zemonkey/Isolated_UART/Isolated_UART.kicad_pcb

## KiCad design Isolated_UART.kicad_pcb (2022-06-12)

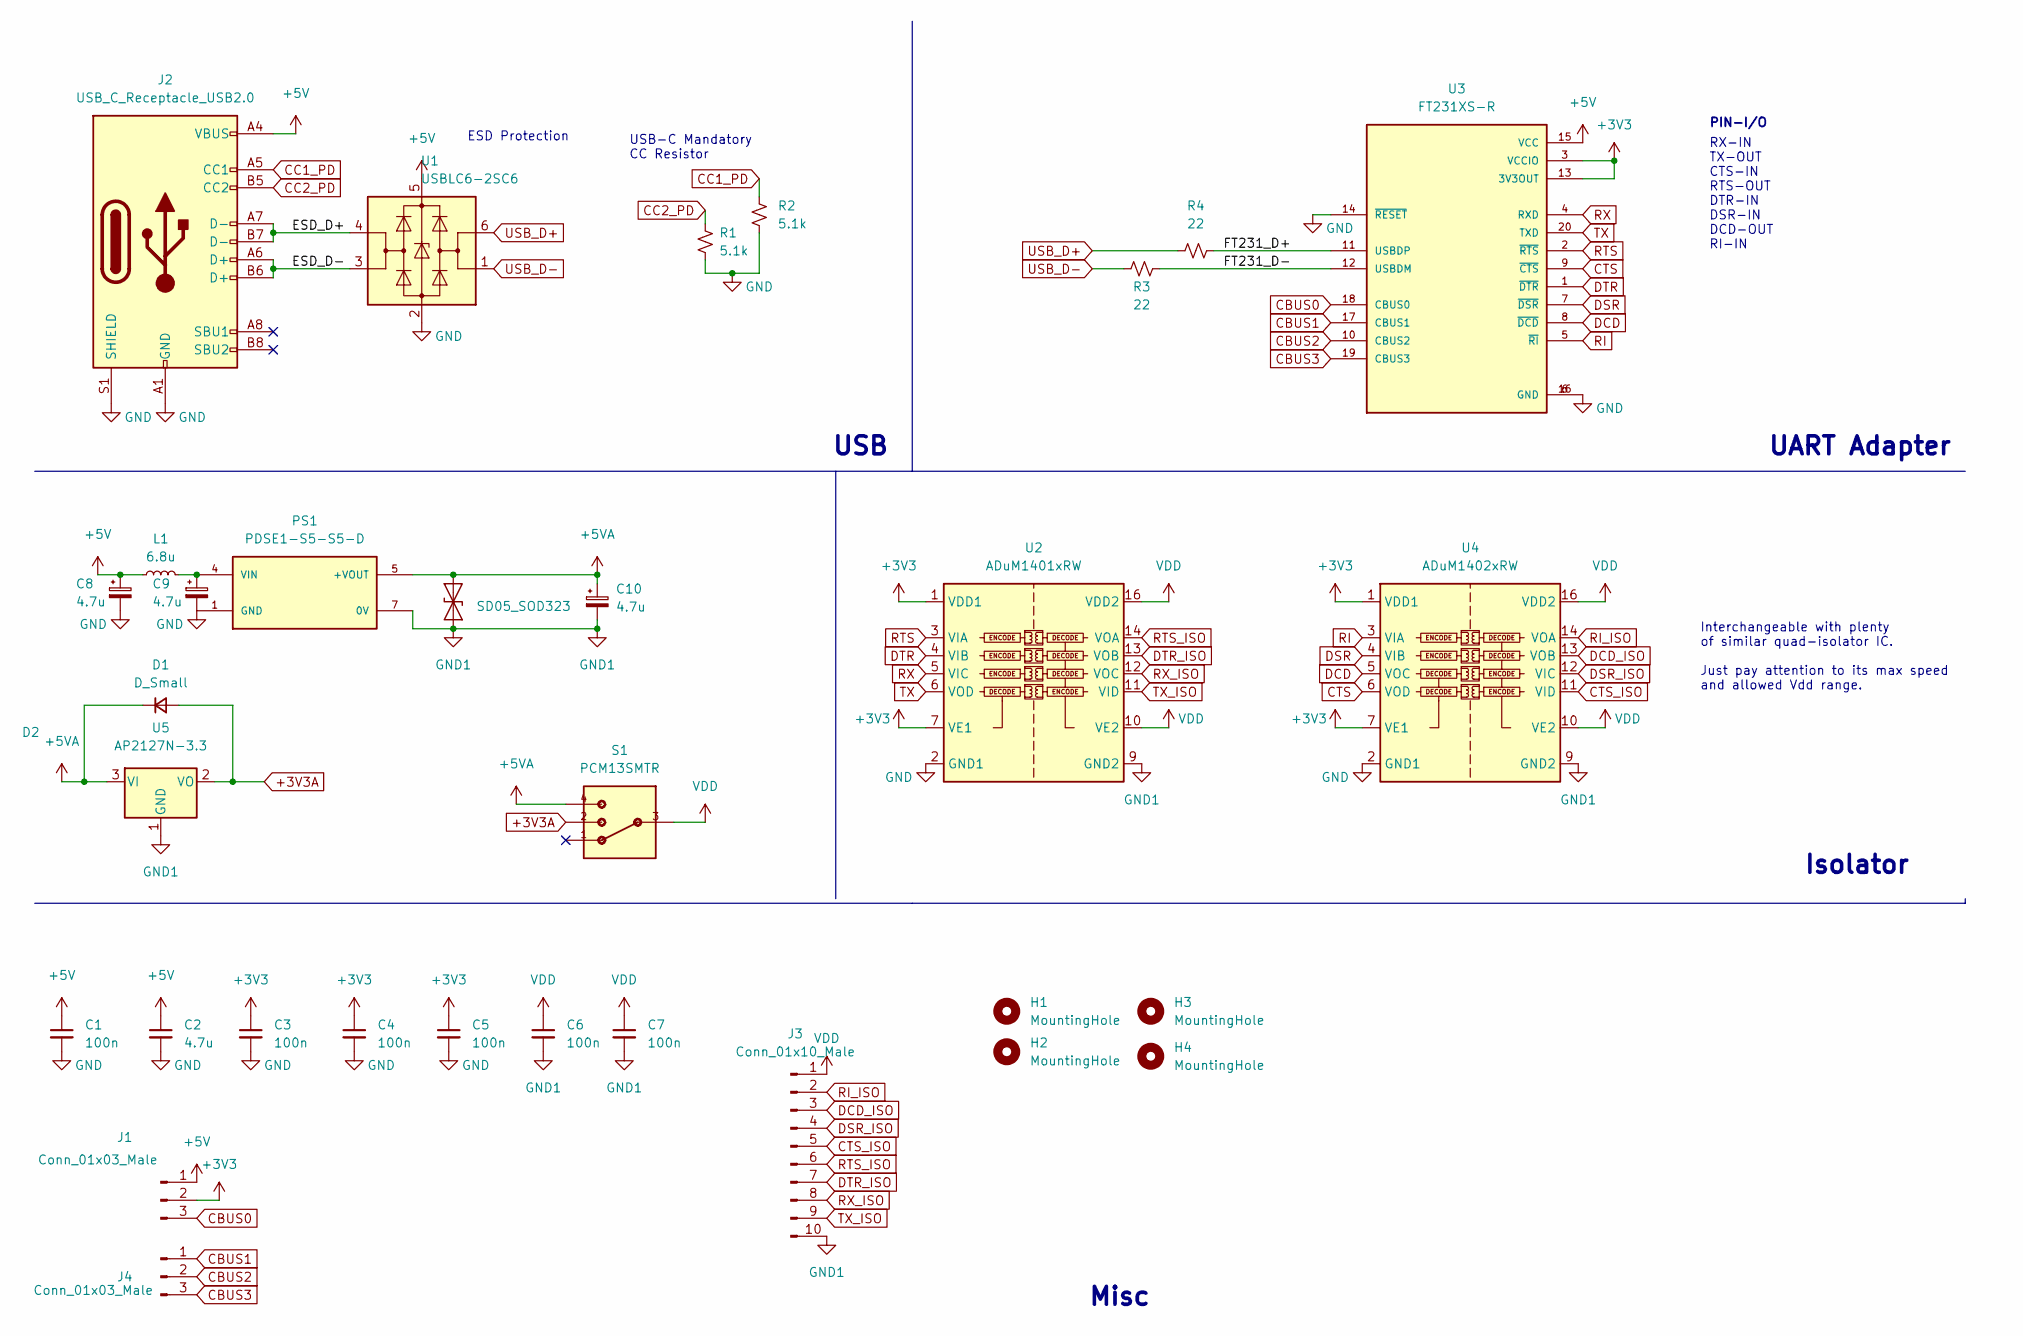
[picture p1: schematic Isolated_UART.kicad_sch]

Parts:
C1, C3, C4, C5, C6, C7: 100n; C_0603_1608Metric_Pad1.08x0.95mm_HandSolder
C2: 4.7u; C_0603_1608Metric_Pad1.08x0.95mm_HandSolder
C8, C9, C10: 4.7u; CP_Radial_D5.0mm_P2.00mm
D1: D_Small; D_SOD-323_HandSoldering
D2: SD05_SOD323; D_SOD-323
H1, H2, H3, H4: MountingHole; MountingHole_3.2mm_M3_DIN965
J1, J4: Conn_01x03_Male; PinHeader_1x03_P2.54mm_Vertical
J2: USB_C_Receptacle_USB2.0; USB_C_Receptacle_XKB_U262-16XN-4BVC11
J3: Conn_01x10_Male; PinHeader_1x10_P2.54mm_Vertical
L1: 6.8u; L_Wuerth_HCI-5040
PS1: PDSE1-S5-S5-D; CONV_PDSE1-S5-S5-D; PARTREV 1.03
R1, R2: 5.1k; R_0805_2012Metric_Pad1.20x1.40mm_HandSolder
R3, R4: 22; R_0805_2012Metric_Pad1.20x1.40mm_HandSolder
S1: PCM13SMTR; SW_PCM13SMTR
U1: USBLC6-2SC6; SOT-23-6
U2: ADuM1401xRW; SOIC-16W_7.5x10.3mm_P1.27mm
U3: FT231XS-R; SOP63P599X175-20N; PARTREV 1.2
U4: ADuM1402xRW; SOIC-16W_7.5x10.3mm_P1.27mm
U5: AP2127N-3.3; SOT-23

Connections:
+3V3: C3.1, C4.1, C5.1, J1.2, U2.1 (VDD1), U2.7 (VE1), U3.3 (VCCIO), U3.13 (3V3OUT), U4.1 (VDD1), U4.7 (VE1)
+3V3A: D1.2 (A), S1.2, U5.2 (VO)
+5V: C1.1, C2.1, C8.1, J1.1, J2.A4 (VBUS), J2.A9 (VBUS), J2.B4 (VBUS), J2.B9 (VBUS), L1.1, U1.5 (VBUS), U3.15 (VCC)
+5VA: C10.1, D1.1 (K), D2.2 (A2), PS1.5 (+VOUT), S1.4, U5.3 (VI)
/ESD_D+: J2.A7 (D-), J2.B7 (D-), U1.4 (I/O2)
/ESD_D-: J2.A6 (D+), J2.B6 (D+), U1.3 (I/O2)
/FT231_D+: R4.2, U3.11 (USBDP)
/FT231_D-: R3.2, U3.12 (USBDM)
CBUS0: J1.3, U3.18 (CBUS0)
CBUS1: J4.1, U3.17 (CBUS1)
CBUS2: J4.2, U3.10 (CBUS2)
CBUS3: J4.3, U3.19 (CBUS3)
CC1_PD: J2.A5 (CC1), R2.1
CC2_PD: J2.B5 (CC2), R1.2
CTS: U3.9 (~CTS), U4.6 (VOD)
CTS_ISO: J3.5, U4.11 (VID)
DCD: U3.8 (~DCD), U4.5 (VOC)
DCD_ISO: J3.3, U4.13 (VOB)
DSR: U3.7 (~DSR), U4.4 (VIB)
DSR_ISO: J3.4, U4.12 (VIC)
DTR: U2.4 (VIB), U3.1 (~DTR)
DTR_ISO: J3.7, U2.13 (VOB)
GND: C1.2, C2.2, C3.2, C4.2, C5.2, C8.2, C9.2, J2.A1 (GND), J2.A12 (GND), J2.B1 (GND), J2.B12 (GND), J2.S1 (SHIELD), PS1.1 (GND), R1.1, R2.2, U1.2 (GND), U2.2 (GND1), U2.8 (GND1), U3.6 (GND), U3.14 (~RESET), U3.16 (GND), U4.2 (GND1), U4.8 (GND1)
GND1: C6.2, C7.2, C10.2, D2.1 (A1), J3.10, PS1.7 (0V), U2.9 (GND2), U2.15 (GND2), U4.9 (GND2), U4.15 (GND2), U5.1 (GND)
unnamed: C9.1, L1.2, PS1.4 (VIN)
RI: U3.5 (~RI), U4.3 (VIA)
RI_ISO: J3.2, U4.14 (VOA)
RTS: U2.3 (VIA), U3.2 (~RTS)
RTS_ISO: J3.6, U2.14 (VOA)
RX: U2.5 (VIC), U3.4 (RXD)
RX_ISO: J3.8, U2.12 (VOC)
TX: U2.6 (VOD), U3.20 (TXD)
TX_ISO: J3.9, U2.11 (VID)
USB_D+: R4.1, U1.6 (I/O1)
USB_D-: R3.1, U1.1 (I/O1)
VDD: C6.1, C7.1, J3.1, S1.3, U2.10 (VE2), U2.16 (VDD2), U4.10 (VE2), U4.16 (VDD2)

Notes on the sheet:
USB-C Mandatory CC Resistor
Interchangeable with plenty of similar quad-isolator IC. Just pay attention to its max speed and allowed Vdd range.
ESD Protection
USB
Misc
UART Adapter
Isolator
RX-IN TX-OUT CTS-IN RTS-OUT DTR-IN DSR-IN DCD-OUT RI-IN
PIN-I/O

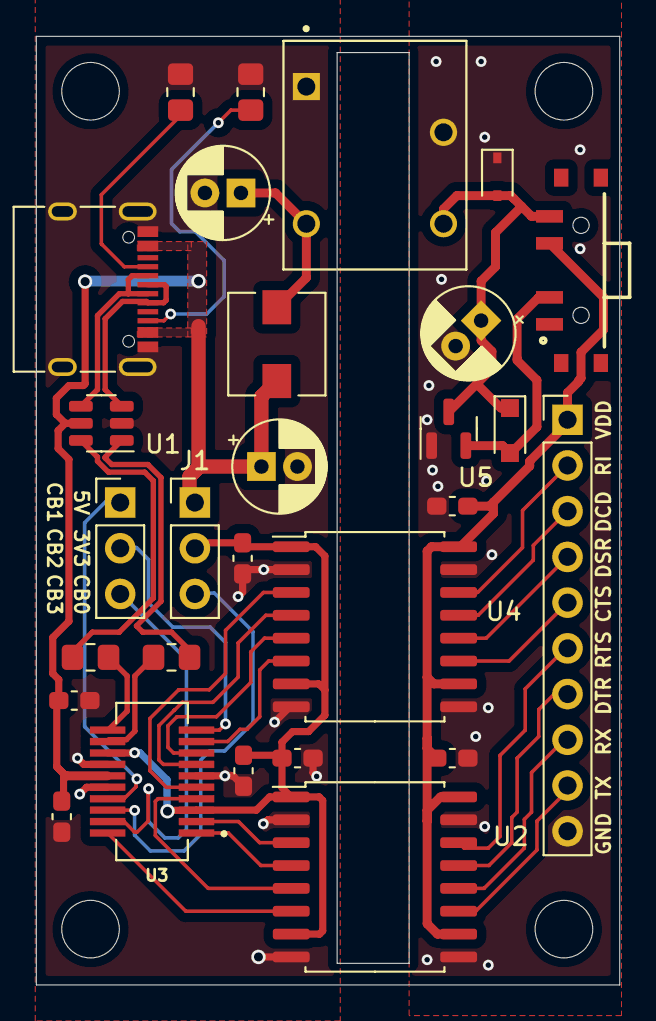
[picture p2: board Isolated_UART.kicad_pcb from above]

Board: 2 copper layers, 32.4 x 52.7 mm, 32 parts (0 on the bottom side), 36 nets.
